lukeweston/SEGmeter20/AnalogInputSchematic.png

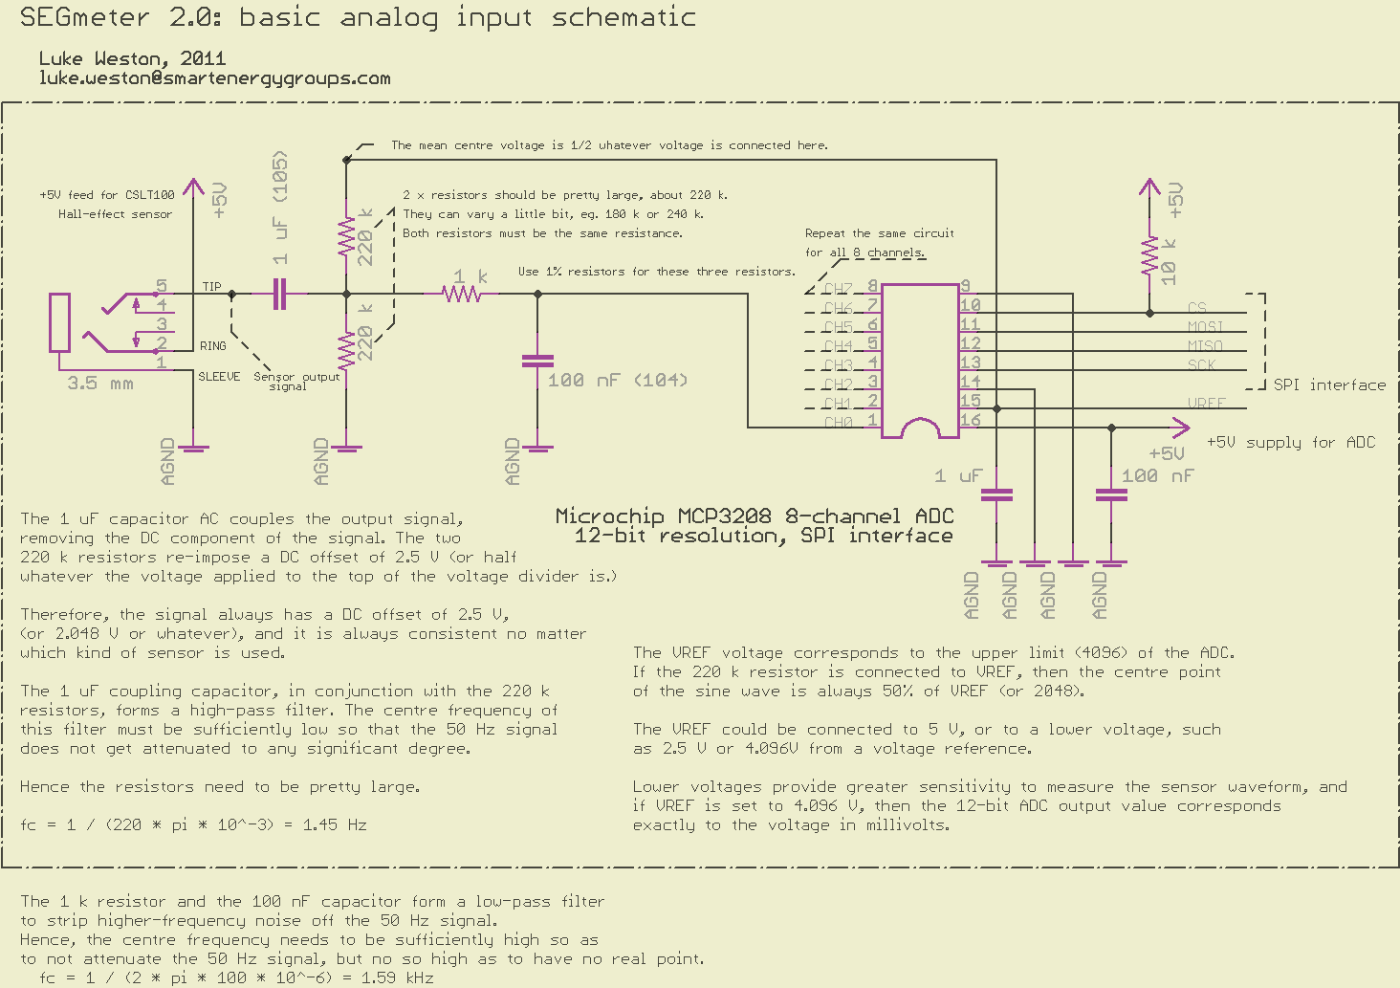
AnalogInputSchematic.png
