lukeweston/SEGmeter20/SEGmeter20PCB.png

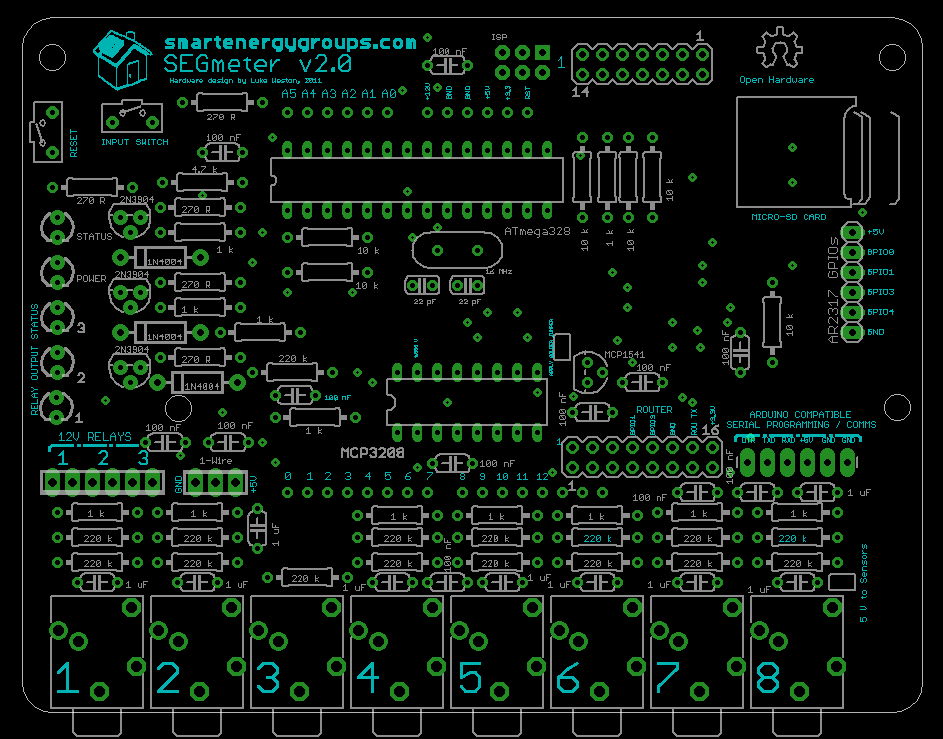
SEGmeter20PCB.png
