lukeweston/SEGmeter20/SEGmeter20schematic.png

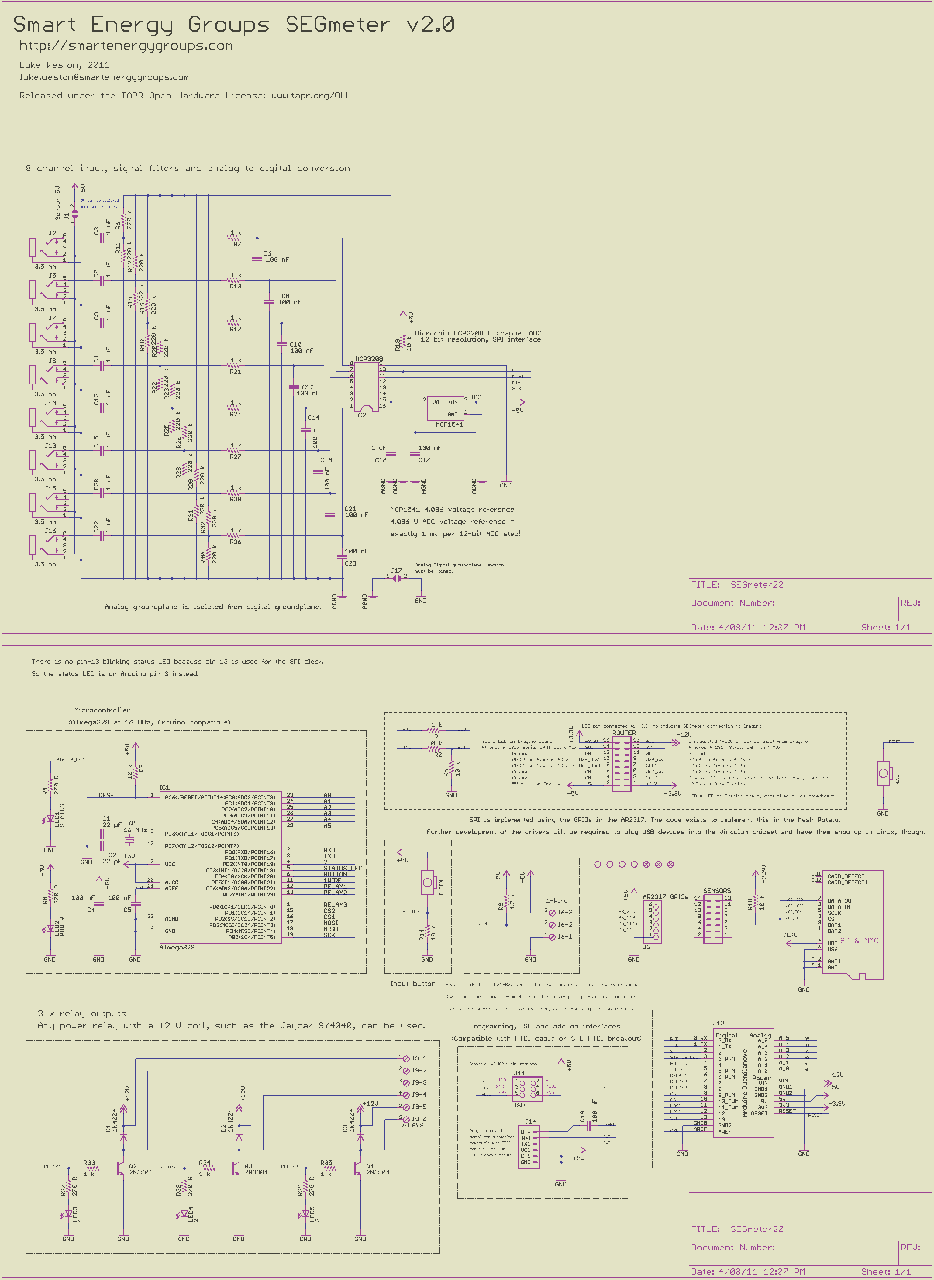
SEGmeter20schematic.png
