lukeweston/SEGmeter20/SEGmeterShieldBoard.png

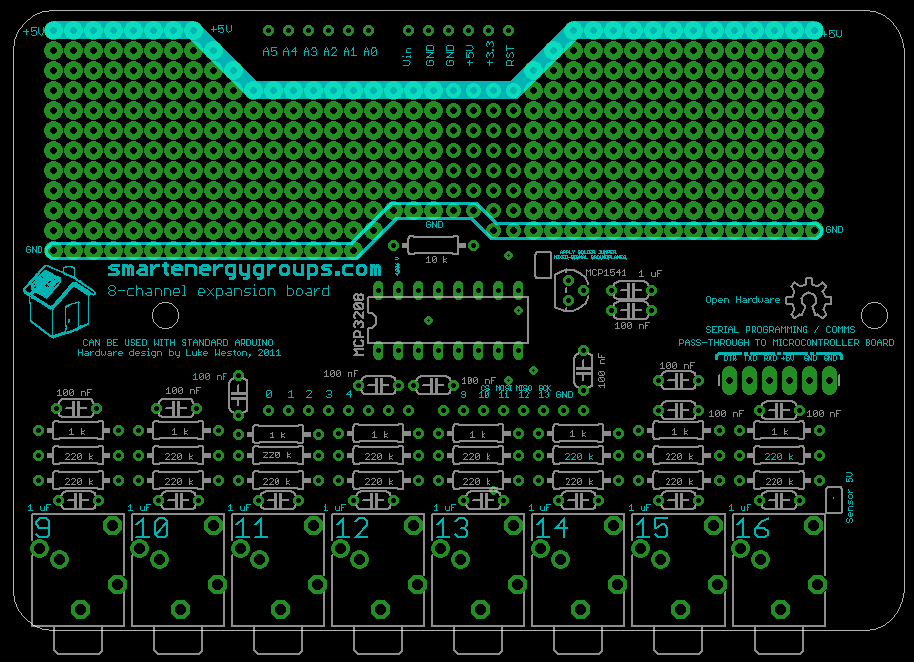
SEGmeterShieldBoard.png
