lukeweston/SEGmeter20/SEGmeterShieldSchematic.png

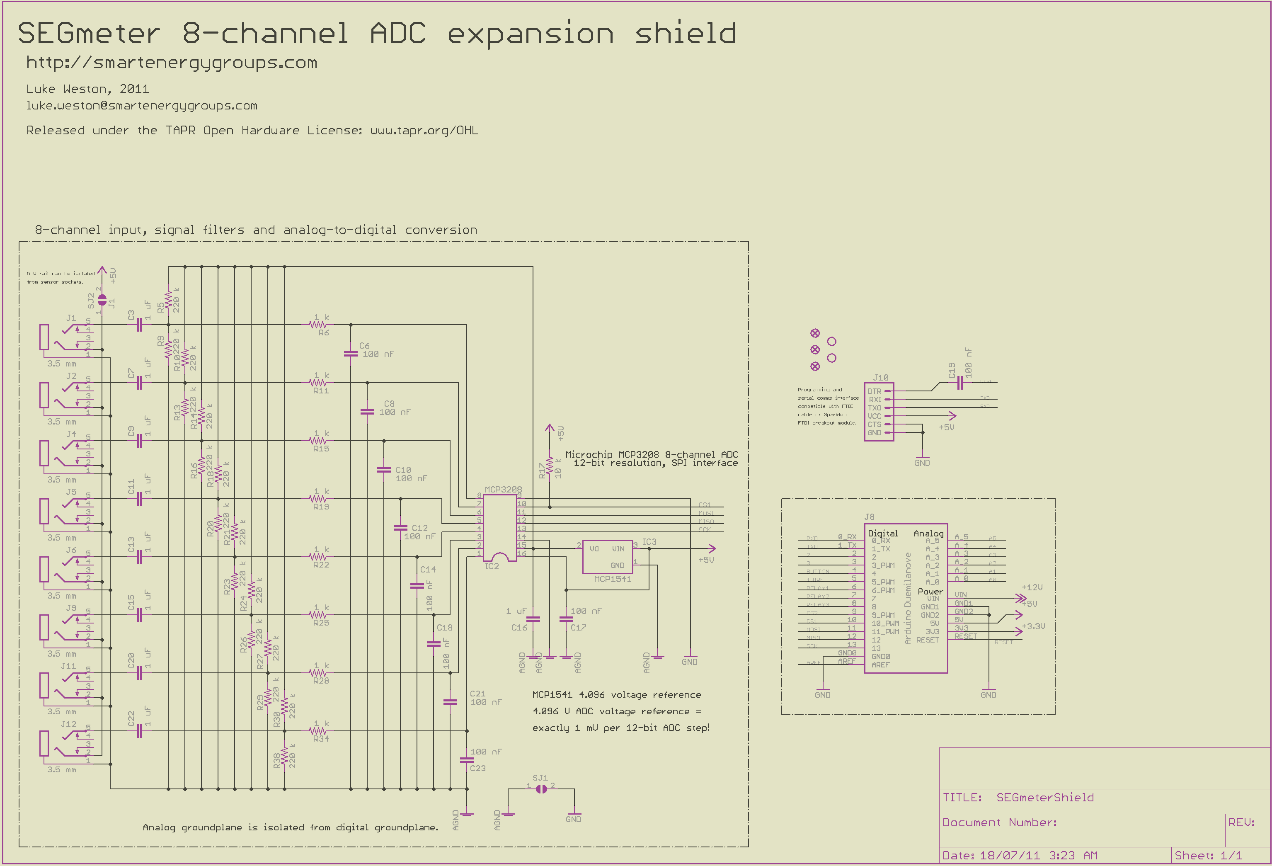
SEGmeterShieldSchematic.png
