lukeweston/SEGmeter20/SEGmeter20XBeeShield/SEGmeter20XBeeShield-schematic.pdf

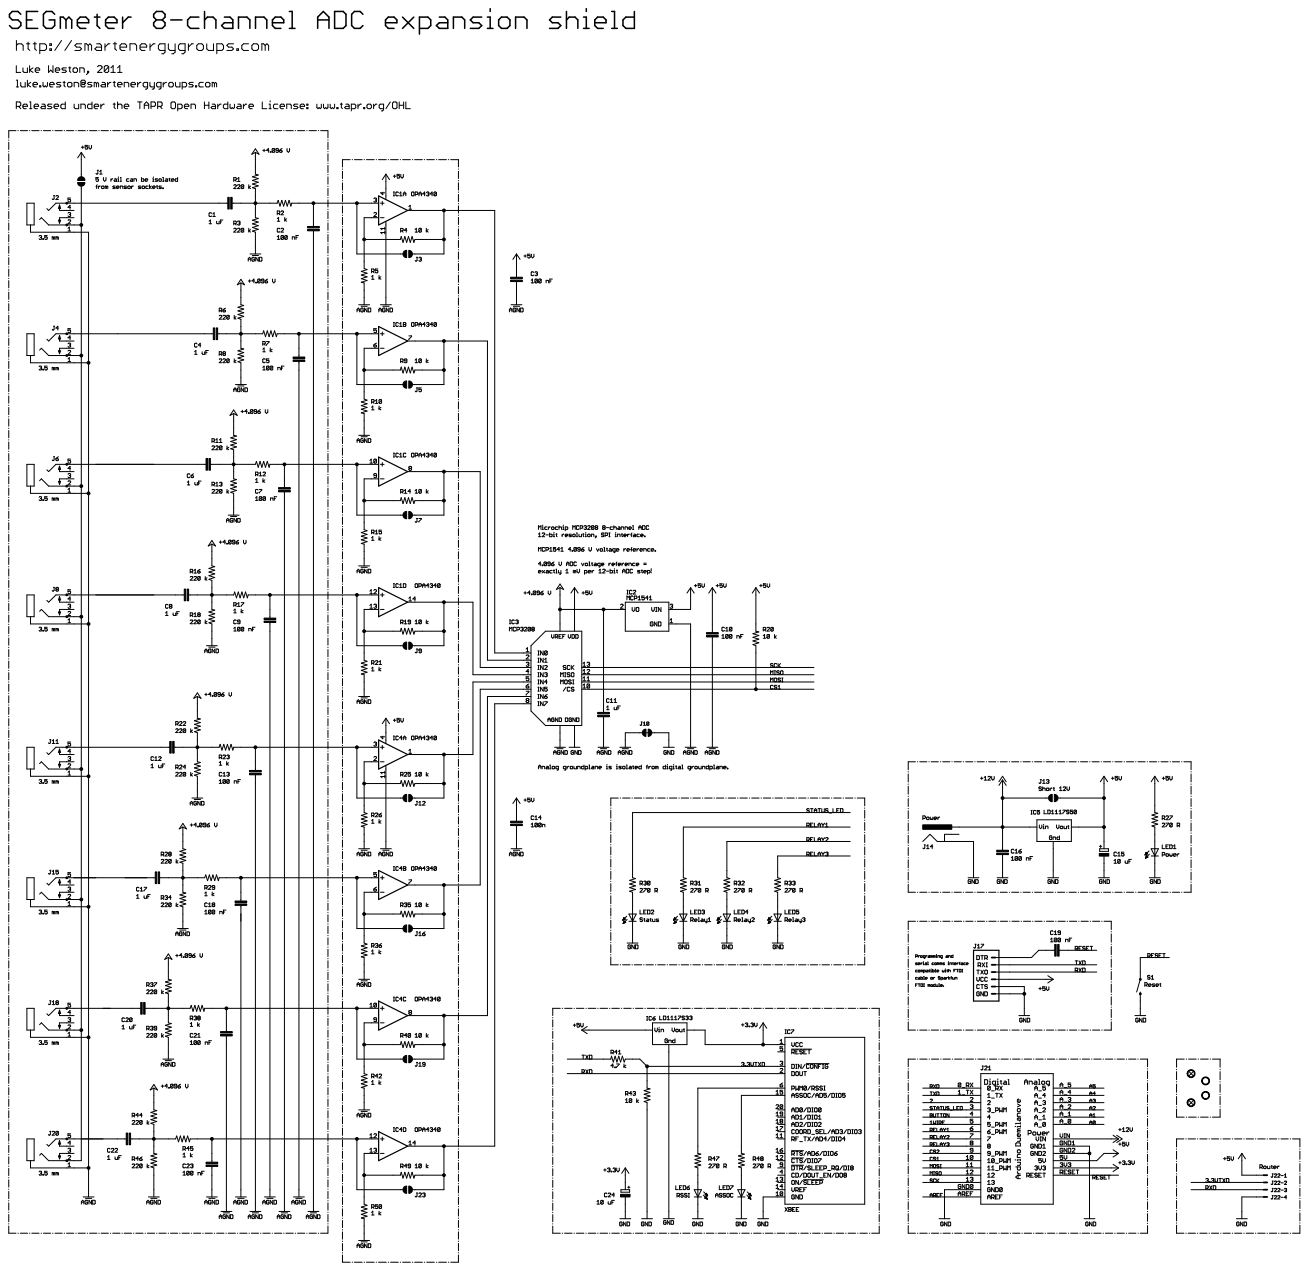
[picture p6: page 1]
