lukeweston/SEGmeter20/SEGmeter20.pdf

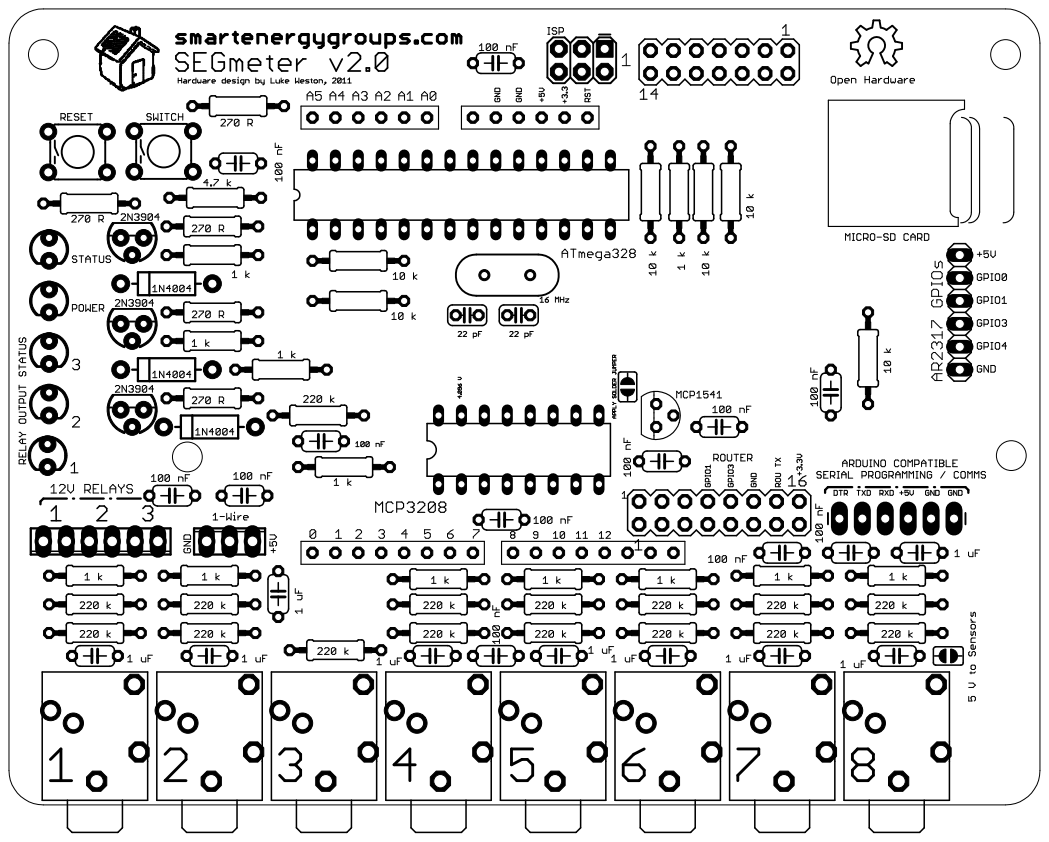
[picture p7: page 1]
