lukeweston/SEGmeter20/SEGmeter20XBeeShield/SEGmeter20XBeeShield-board.pdf

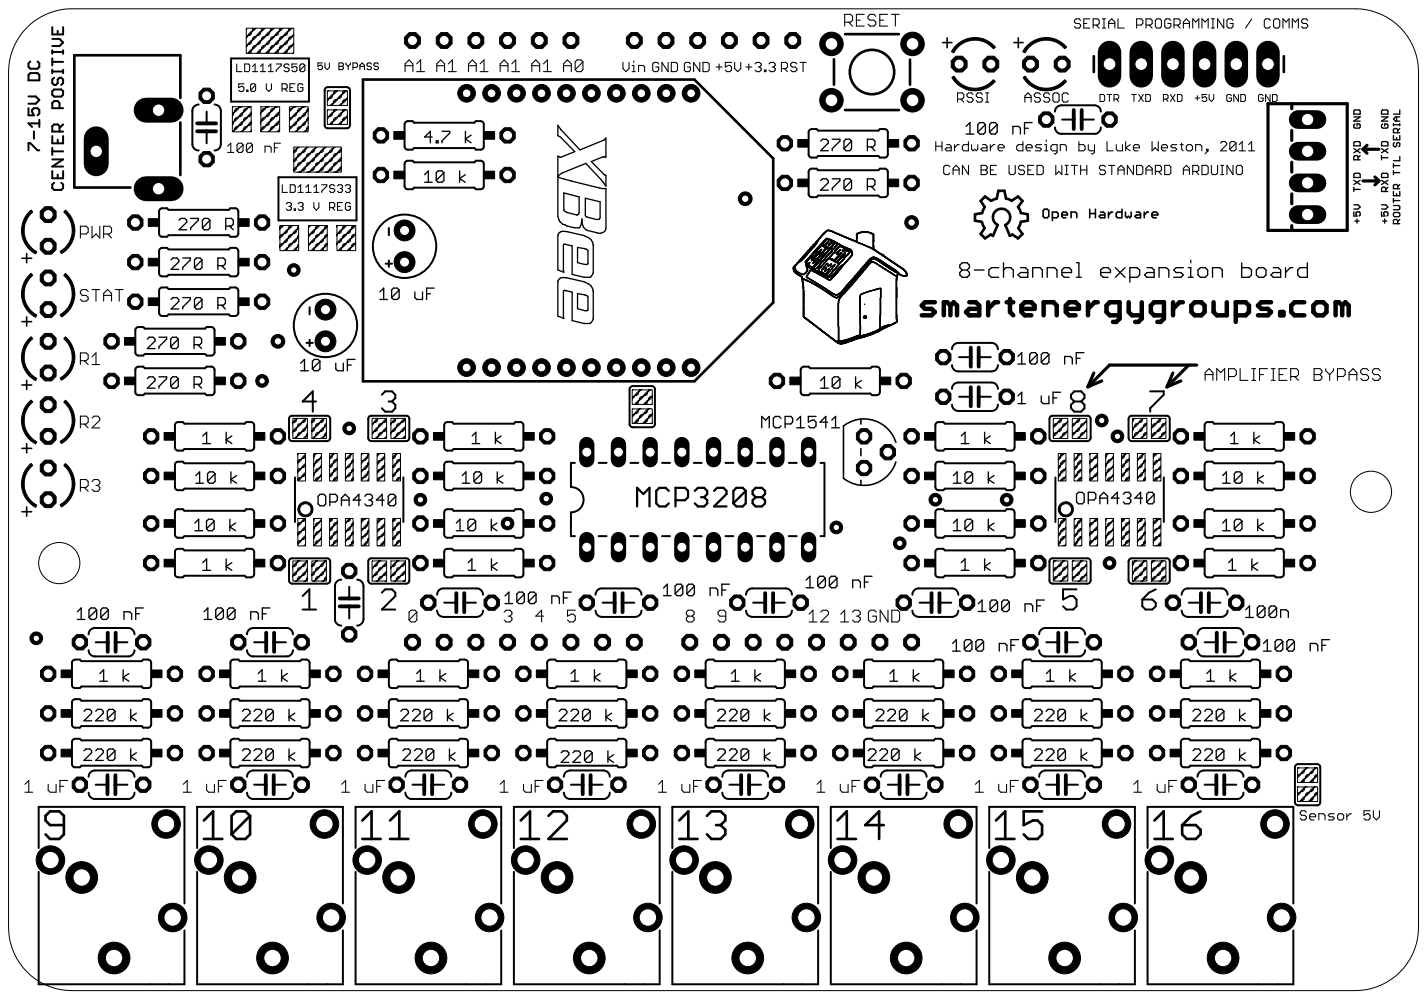
[picture p8: page 1]
