lukeweston/SEGmeter20/(commit log)

2011-06-29 added microSD card socket
    [SEGmeter20.brd, SEGmeter20.sch]
2011-06-29 added reset button, tweaks
    [AnalogInput.sch, SEGmeter20.brd, SEGmeter20.sch, SEGmeterShield.brd, SEGmeterShield.sch]
2011-06-29 updated expansion board
    [SEGmeterShield.brd, SEGmeterShield.sch]
2011-07-08 Generated Gerber files
    [SEGmeter20.brd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]
2011-11-30 added new expansion board with sensor amplifier and XBee support.
    [SEGmeter20XBeeShield.brd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]
2011-12-01 Added new XBee expansion shield
    [SEGmeter20XBeeShield.brd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]
2011-12-06 added gerbers in zip file, moved DC jack to top
    [SEGmeter20XBeeShield.brd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]
